Kymopsis/radar-auto-lock/enclosure/desk-foot.stl

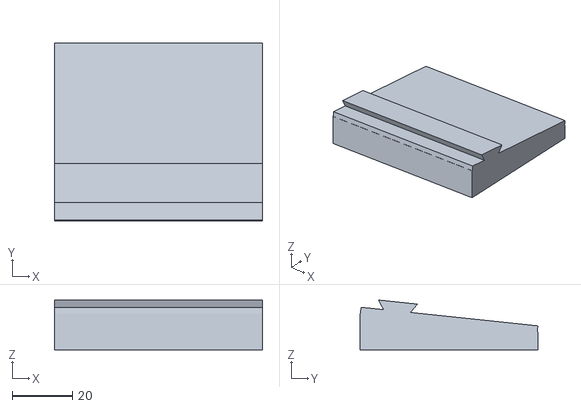
[picture p2: CAD file, 2026-11-12]
enclosure/desk-foot.stl
69.0 x 59.0 x 16.6
