Kymopsis/radar-auto-lock/enclosure/case.stl

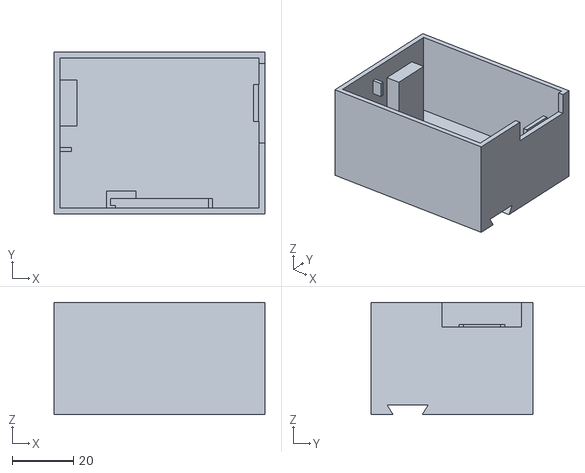
[picture p3: CAD file, 2026-11-12]
enclosure/case.stl
69.0 x 53.0 x 36.7
