Kymopsis/radar-auto-lock/enclosure/lid.stl

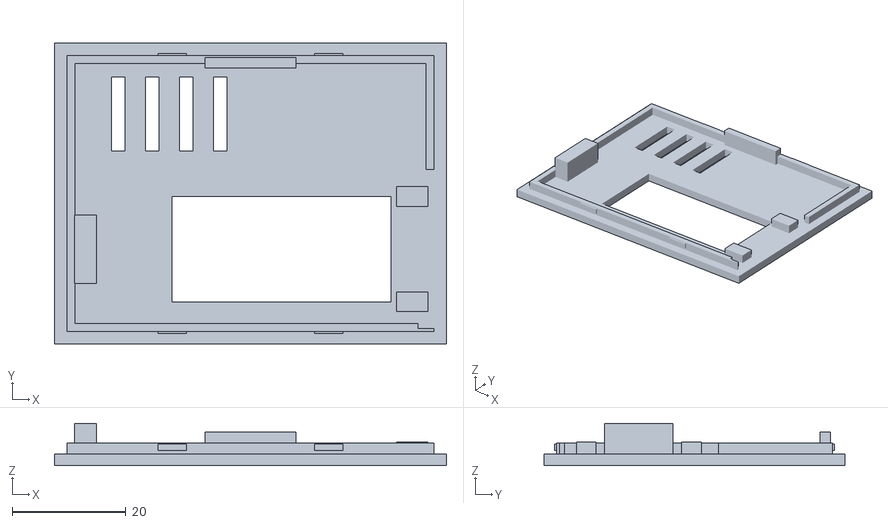
[picture p4: CAD file, 2026-11-12]
enclosure/lid.stl
69.0 x 53.0 x 7.40
