Kymopsis/radar-auto-lock/enclosure/clip-12mm.stl

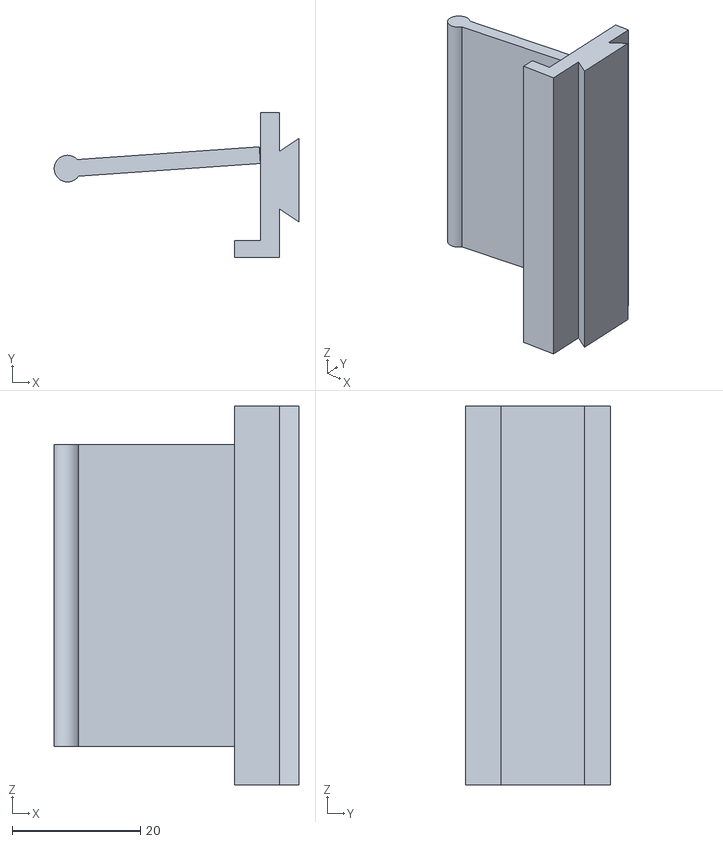
[picture p5: CAD file, 2026-10-31]
enclosure/clip-12mm.stl
38.1 x 22.5 x 59.0
