Kymopsis/radar-auto-lock/enclosure/clip-20mm.stl

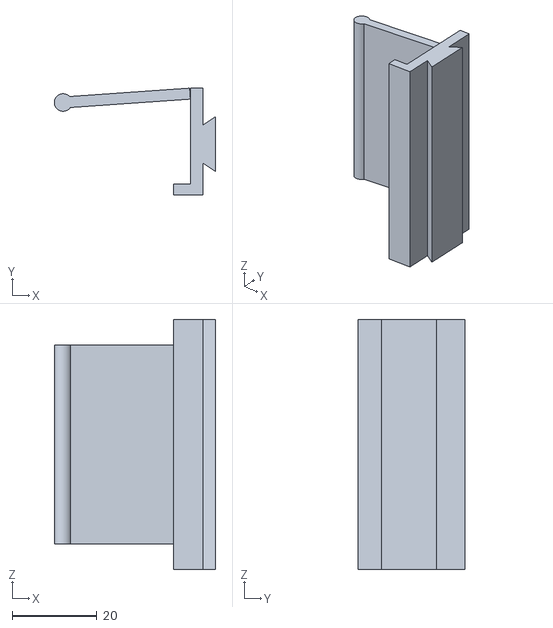
[picture p6: CAD file, 2026-10-31]
enclosure/clip-20mm.stl
38.1 x 25.2 x 59.0
