Kymopsis/radar-auto-lock/(list of files, cad)

Other CAD files:
enclosure/clip-6mm.stl
