Kymopsis/radar-auto-lock/(commit log)

2026-10-31 Radar Auto-Lock v1.0.0: firmware, enclosure and docs
    Locks the PC when you walk away, wakes it when you come back. 60 GHz
    presence radar (TinyFrame UART) + ESP32-S3 as a USB or BLE HID keyboard.
    Includes host tests, a parametric CadQuery enclosure with monitor clips,
    and CI (both firmware variants, host tests, STL regeneration, gitleaks).
    [case.stl, clip-12mm.stl, clip-20mm.stl, clip-6mm.stl, desk-foot.stl, lid.stl]
2026-10-31 Review fixes: fail-safe on undecodable frames, lock retry, licences
    - Radar link counts as up only while target/cloud frames decode; other
    frame types or unknown layouts can no longer lead to a lock.
    - A lock that does not reach the PC is retried every second while away.
    - Key release retried so no modifier stays held; BLE reports wait for
    an encrypted link.
    - Neutral layout names in the decoder, unused fields removed.
    - Exact dev-board notice in README; CC BY 4.0 text for enclosure/docs.
    - Desk foot now keeps its dovetail tongue; larger lid window over BOOT.
    - Docs: button feedback, settings command, clip fit, Win+L policy note.
    [desk-foot.stl, lid.stl]
2026-11-02 LICENSE: plain MIT text so GitHub detects it (#1)
    The scope note moves to the README's License section (unchanged meaning:
    firmware and CI under MIT, docs and enclosure under CC BY 4.0).
    Claude-Session: https://claude.ai/code/session_019iTQwvyoNnK9pa21utdXcz
2026-11-12 Decode the radar's zone-presence frame (0x0A0A), confirm frame layouts in docs
    - radar_link: decode 0x0A0A (4 x u32 per-zone presence flags), show in status
    - new setting 'set zones on|off' (default off) lets the radar's own zone
    flags count as present; zone frames also count as usable data then
    - host test for the zone frame
    - docs: confirmed 20-byte target layout, point cloud usually off, how still
    people stay tracked; drop module model numbers from README, wiring and
    enclosure comments
    Claude-Session: https://claude.ai/code/session_019iTQww4rjdhFax49MQ2Tez
2026-11-12 Hardware: PCB-antenna radar board first, AiP sensor as an alternative
    - README parts: the 60 GHz PCB-antenna radar module (Presence, wall mount
    build), development kit or DIY board; AiP sensor listed as also works
    - wiring: 2.0 mm headers and jumper wires, AiP sensor lead pinout
    - FAQ: which application build to choose; enclosure notes name the board
    the radar slot fits
    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
2026-11-12 Parts: AiP sensor and PCB-antenna DIY board side by side
    Both radars listed with equal weight; the development kit is mentioned
    only as the way to try other application builds later.
    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
2026-11-12 Enclosure: radar slot for the PCB-antenna board with 2.0 mm headers
    - 1.5 mm stand-off behind the window for front chips and header solder tails
    - the pin-free antenna end sits in a channel (front lip outside the patches,
    rear rib); the old rear ribs over the pinned edge are gone, so headers and
    jumper housings slide in and stay clear (checked against the case and lid)
    - lid hold-down stops at the PCB back face; outside size unchanged
    - STLs and preview regenerated; assembly steps updated
    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
    [case.stl, desk-foot.stl, lid.stl]
